Kamelz70/Battery-Test-Bench/BatteryTB_BTMC/circuit_measurements.cpp

#include "circuit_measurements.h"
#include <Adafruit_ADS1X15.h>
#include "circuit_config.h"
#include "circuit_ads.h"

///////////////////// Mock data ranges
// #define MIN_VOLTAGE 3.0
// #define MAX_VOLTAGE 4.2
// #define MIN_CURRENT -5.0  // Negative for discharging
// #define MAX_CURRENT 5.0   // Positive for charging
#define MIN_TEMP 20.0
#define MAX_TEMP 45.0
#define MIN_SOH 80.0
#define MAX_SOH 100.0
#define MIN_SOC 0.0
#define MAX_SOC 100.0

float savedTemperature = 0;
void measurementSetup()
{
  // initialize comm with other arduino
  Serial1.begin(9600, SERIAL_8N1, NANO_SERIAL_RX_PIN, -1);
  while (1)
  {
    Serial.println("Awaiting first reading of temperature");
    if (Serial1.available())
    {
      updateTemperature();
      break;
    }
  }
}
void updateTemperature()
{
  String temperString = Serial1.readStringUntil('\n');
  Serial.print("Temperature from Nano: ");
  Serial.println(temperString);
  savedTemperature = temperString.toFloat();
}
float getSavedTemperature()
{
  return savedTemperature;
}

VoltageCurrentReading getVoltageAndCurrent(enum CIRCUITMODE CircuitMode)
{
  float voltage_diff;
  VoltageCurrentReading result;
  // Read battery voltage from A0 (after voltage divider)
  int16_t adc_volt = ads.readADC_SingleEnded(0);

  result.voltage = VOLTAGE_DIVIDER_FACTOR * adc_volt * (4.096 / 32768.0);

  // Read differential voltage across shunt (A1 - A3), also through voltage divider
  int16_t adc_diff = ads.readADC_Differential_1_3();
  voltage_diff = adc_diff * (4.096 / 32768.0);
  result.voltage_diff = voltage_diff;
  // Calculate current using 0.5 ohm shunt
  if (CircuitMode == CIRCUITCHARGING)
  {
    result.current = -(voltage_diff / 0.5) * VOLTAGE_DIVIDER_FACTOR;
  }
  else if (CircuitMode == CIRCUITDISCHARGING||CircuitMode == CIRCUITOFF)
  {
    result.current = (voltage_diff / 0.5) * VOLTAGE_DIVIDER_FACTOR;
  }
  return result;
}

float getSOC(enum CIRCUITMODE CircuitMode,float voltage,bool pulseState)
{
  if(CircuitMode==CIRCUITOFF||pulseState==false)
  {
    return -1;
  }
  return (100-((4.8-voltage)/0.02));  
}
String getRealtimeDataString(enum CIRCUITMODE circuitMode,bool pulseState)
{
  String modeString = "o";
  switch (circuitMode)
  {
  case CIRCUITCHARGING:
    modeString = "c";
    break;
  case CIRCUITDISCHARGING:
    modeString = "d";
    break;
  case CIRCUITOFF:
    modeString = "o";
    break;
  }
  // Generate random mock data within ranges
  // float voltage = MIN_VOLTAGE + (rand() % (int)((MAX_VOLTAGE - MIN_VOLTAGE) * 100)) / 100.0;
  // float current = MIN_CURRENT + (rand() % (int)((MAX_CURRENT - MIN_CURRENT) * 100)) / 100.0;
  // float temperature = MIN_TEMP + (rand() % (int)((MAX_TEMP - MIN_TEMP) * 100)) / 100.0;
  VoltageCurrentReading VoltageCurrentS = getVoltageAndCurrent(circuitMode);
  float current = VoltageCurrentS.current;
  float voltage = VoltageCurrentS.voltage;
  float temperature = getSavedTemperature();
  float soh = MIN_SOH + (rand() % (int)((MAX_SOH - MIN_SOH) * 100)) / 100.0;
  float soc = getSOC(circuitMode,voltage,pulseState);
  String result=String(voltage, 2) + "," + String(current, 2) + "," + String(temperature, 2) + "," + String(soh, 2) + "," + String(soc, 2) + "," + modeString;
  return result;
}
