Kamelz70/Battery-Test-Bench/BatteryTB_BTMC/circuit_operation.h

#ifndef CIRCUIT_OPERATION_H
#define CIRCUIT_OPERATION_H
#include <Arduino.h>
#include "custom_types.h"
// Config
#define ADC_VOLTAGE_CHANNEL 0
#define ADC_CURRENT_CHANNEL 1
#define PWM_CHANNEL 1

void circuitOperationSetup();
void operateCircuit(enum CIRCUITMODE CircuitMode);
float getCircuitVoltage();
float getCircuitCurrent();
void setPulseOnTime(unsigned long pulseOnTimeInput);
void setPulseOffTime(unsigned long pulseOffTimeInput);
void setDesiredCurrent(float desiredCurrentInput);
bool getPulseState();
void triggerSafetyRelay();

#endif
