Kamelz70/Battery-Test-Bench/BatteryTB_BTMC/circuit_safety.cpp

#include "circuit_safety.h"
#include "circuit_config.h"

CIRCUITSAFETYCODE checkCircuitSafety(float current, float voltage, float temperature,enum CIRCUITMODE circuitMode)
{

  if (!isTemperatureSafe(temperature))
  {
    return TEMPERATURE_OUT_OF_RANGE;
  }
  if (!isCurrentSafe(current,circuitMode))
  {
    return CURRENT_OUT_OF_RANGE;
  }
  if (!isVoltageSafe(voltage,circuitMode))
  {
    return  VOLTAGE_OUT_OF_RANGE;
  }
  return ALL_SAFE;
}
String getSafetyCodeString(CIRCUITSAFETYCODE safetyCode)
{
switch (safetyCode)
  {
    case ALL_SAFE:
      return "All safety conditions are within range";
    case TEMPERATURE_OUT_OF_RANGE:
      return "Error: Temperature out of range";
    case CURRENT_OUT_OF_RANGE:
      return "Error: Current out of range";
    case VOLTAGE_OUT_OF_RANGE:
      return "Error: Voltage out of range";
    default:
      return "Unknown safety status";
  }
}

bool isTemperatureSafe(float temperature)
{
  if (temperature > MAX_TEMPERATURE)
  {
    return false;
  }
  if (temperature < MIN_TEMPERATURE)
  {
    return false;
  }
  return true;
}

bool isCurrentSafe(float current,enum CIRCUITMODE circuitMode)
{
  if (current > MAX_CURRENT)
  {
    return false;
  }
  if (current < MIN_CURRENT&&circuitMode!=CIRCUITOFF)
  {
    return false;
  }
  return true;
}
bool isVoltageSafe(float voltage,enum CIRCUITMODE circuitMode)
{
  if (voltage > MAX_VOLTAGE)
  {
    return false;
  }
  if (voltage < MIN_VOLTAGE&&circuitMode!=CIRCUITOFF)
  {
    return false;
  }
  return true;
}
