Kamelz70/Battery-Test-Bench/(commit log)

2025-05-13 integrated BLE and Circuit operation
2025-05-13 fixed BLE send trigger in loop
    [BatteryTB_BTMC.ino, bluetooth_controller.cpp, circuit_operation.cpp, circuit_operation.h, custom_types.h]
2025-05-16 updated circuit operation
    added charging and discharging cycle( pulse discharge/charge).
    corrected voltage divider value
    made function for reading voltage and current and correced it .
    [BatteryTB_BTMC.ino, bluetooth_controller.cpp, bluetooth_controller.h, circuit_control.h, circuit_operation.cpp, circuit_operation.h, custom_types.h]
2025-05-23 added circuit_safety, Config.h, circuit_measurements
2025-06-11 commented ADC code for main to run
2025-06-13 Sends settings from arduino to phone on connect
2025-06-13 refactored circuit control to its module
2025-06-15 extracted current,coltage measurement
2025-06-15 extracted PIN numbers to confing
2025-06-15 added placeholder for circuitOff
2025-06-15 replaced operation measurement from measurement module
    [circuit_measurements.h, circuit_operation.cpp]
2025-06-15 added safety relay code, handle off
2025-06-15 added set current from app
2025-06-19 send Volt Curr to phone
2025-06-19 fixed voltage_diff
2025-06-19 temperature integrated
2025-06-19 Fixed safety on off
    [BatteryTB_BTMC.ino, circuit_config.h, circuit_operation.cpp, circuit_safety.cpp, circuit_safety.h]
2025-06-19 added safety relay
2025-06-19 fixed reading current and voltage
    [BatteryTB_NormalNano.ino, circuit_config.h, circuit_measurements.cpp]
